bastian-bou/NixieNTPClock/README.md

# NixieNTPClock
Nixie clock around ESP32 connected to a NTP server

You can find the KiCad project and gerbers in **Hardware** folder and the PlatformIO project with arduino framwork in **Software** project

I am using ESP32 WROOM 32
