bastian-bou/NixieNTPClock/Hardware/NixieNTPClockFarnell.xlsx

Value | Footprint | Farnell | Quantité
100µF-16V | Capacitors_SMD:CP_Elec_6.3x7.7 | 1850114 | 1
100nF | Capacitors_SMD:C_0805_HandSoldering | 1740665 | 1
1nF | Capacitors_SMD:C_0603_HandSoldering | 1414605 (https://fr.farnell.com/kemet/c0603c102j5gactu/cond-1000pf-50v-5-c0g-np0-0603/dp/1414605) | 1
10K | Resistors_SMD:R_1206_HandSoldering | 2861595 (https://fr.farnell.com/te-connectivity/crgcq1206f10k/res-aec-q200-couche-epaisse-10k/dp/2861595) | 1
1K | Resistors_SMD:R_1206_HandSoldering | 1469965 (https://fr.farnell.com/vishay/crcw12061k00fkea/res-couche-epaisse-1k-1-0-25w/dp/1469965) | 1
33 | Resistors_SMD:R_1206_HandSoldering | 2447506 (https://fr.farnell.com/multicomp/mcwr12x33r0ftl/resistance-thick-film-33ohm-1/dp/2447506) | 1
TLC555 | Housings_DIP:DIP-8_W7.62mm_SMDSocket_SmallPads | 3121208 (https://fr.farnell.com/texas-instruments/tlc555cdr/ic-timer-smd-soic8-555/dp/3121208?st=TLC555) | 1
2200pF | Capacitors_SMD:C_0603_HandSoldering | 2470451 | 1
1mH 1A | Inductors:Inductor_Wurth_HCI-1335 | 2288316 | 1
Q_NMOS_GDS | TO_SOT_Packages_SMD:TO-252-2 | 2453852 | 1
4.7 | Resistors_SMD:R_1206_HandSoldering | 2447524 (https://fr.farnell.com/multicomp/mcwr12w4r70ftl/resistance-thick-film-4-7ohm-1/dp/2447524) | 1
MBRS3200T3G | Diodes_SMD:D_SMB_Handsoldering | 1838812 | 1
4.7µF-250V | Capacitors_SMD:CP_Elec_10x7.7 | 2326350 | 1
220K | Resistors_SMD:R_1206_HandSoldering | 2447485 (https://fr.farnell.com/multicomp/mcwr12x2203ftl/resistance-thick-film-220kohm/dp/2447485) | 1
470 | Resistors_SMD:R_1206_HandSoldering | 2447520 (https://fr.farnell.com/multicomp/mcwr12x4700ftl/res-couche-epaisse-470r-1-0-25w/dp/2447520) | 1
1K | Potentiometers:Potentiometer_Trimmer_Vishay_TS53YJ | 1141482 | 1
5K6 | Resistors_SMD:R_1206_HandSoldering | 2447530 (https://fr.farnell.com/multicomp/mcwr12x5601ftl/resistance-thick-film-5-6kohm/dp/2447530) | 1
BC850 | TO_SOT_Packages_SMD:SOT-23W_Handsoldering | 1081241 | 1
TLP627-4 | Housings_DIP:DIP-16_W7.62mm_Socket_LongPads | 1225840 | 1
220 | Resistors_SMD:R_1206_HandSoldering | 2447486 (https://fr.farnell.com/multicomp/mcwr12x2200ftl/res-couche-epaisse-220r-1-0-25w/dp/2447486) | 1
74HC7014 | Housings_SOIC:SOIC-14_3.9x8.7mm_Pitch1.27mm | 2777749 | 1
DS18B20 | TO_SOT_Packages_THT:TO-92_Inline_Wide | 2515553 (https://fr.farnell.com/maxim-integrated-products/ds18b20/temperature-sensor/dp/2515553?st=DS18B20) | 1
4.7K | Resistors_SMD:R_1206_HandSoldering | 2447523 (https://fr.farnell.com/multicomp/mcwr12x4701ftl/res-couche-epaisse-4-7k-1-0-25w/dp/2447523) | 1
FQT4N25TF | TO_SOT_Packages_SMD:SOT-223-3_TabPin2 | 2453914 | 4
100K | Resistors_SMD:R_1206_HandSoldering | 2447453 (https://fr.farnell.com/multicomp/mcwr12x1003ftl/res-couche-epaisse-100k-1-0-25w/dp/2447453) | 1
TPS562200 | TO_SOT_Packages_SMD:SOT-23-6 | 2781737 | 1
22µF | Capacitors_SMD:CP_Elec_5x5.8 | 9695737 | 5
4.7µH | Inductors:SELF-WE-TPC_M | 2066938 | 1
54K9 | Resistors_SMD:R_1206_HandSoldering | 2307762 (https://fr.farnell.com/panasonic/erj8enf5492v/res-couche-epaisse-54-9k-1-0-25w/dp/2307762) | 1
D_Zener | Diodes_SMD:D_SMB_Handsoldering | 2844801 | 1
7150 | Resistors_SMD:R_1206_HandSoldering | 2307836 | 1
LED | Diodes_SMD:D_0603 | 8529833 | 1
 | Support tulipe DIP 16 |  | 2
 | Barette tulipe 2,54mm
Embase LEMO 2p | Commande RS | 173-2253 | 1
