bastian-bou/NixieNTPClock/Hardware/Schema.pdf

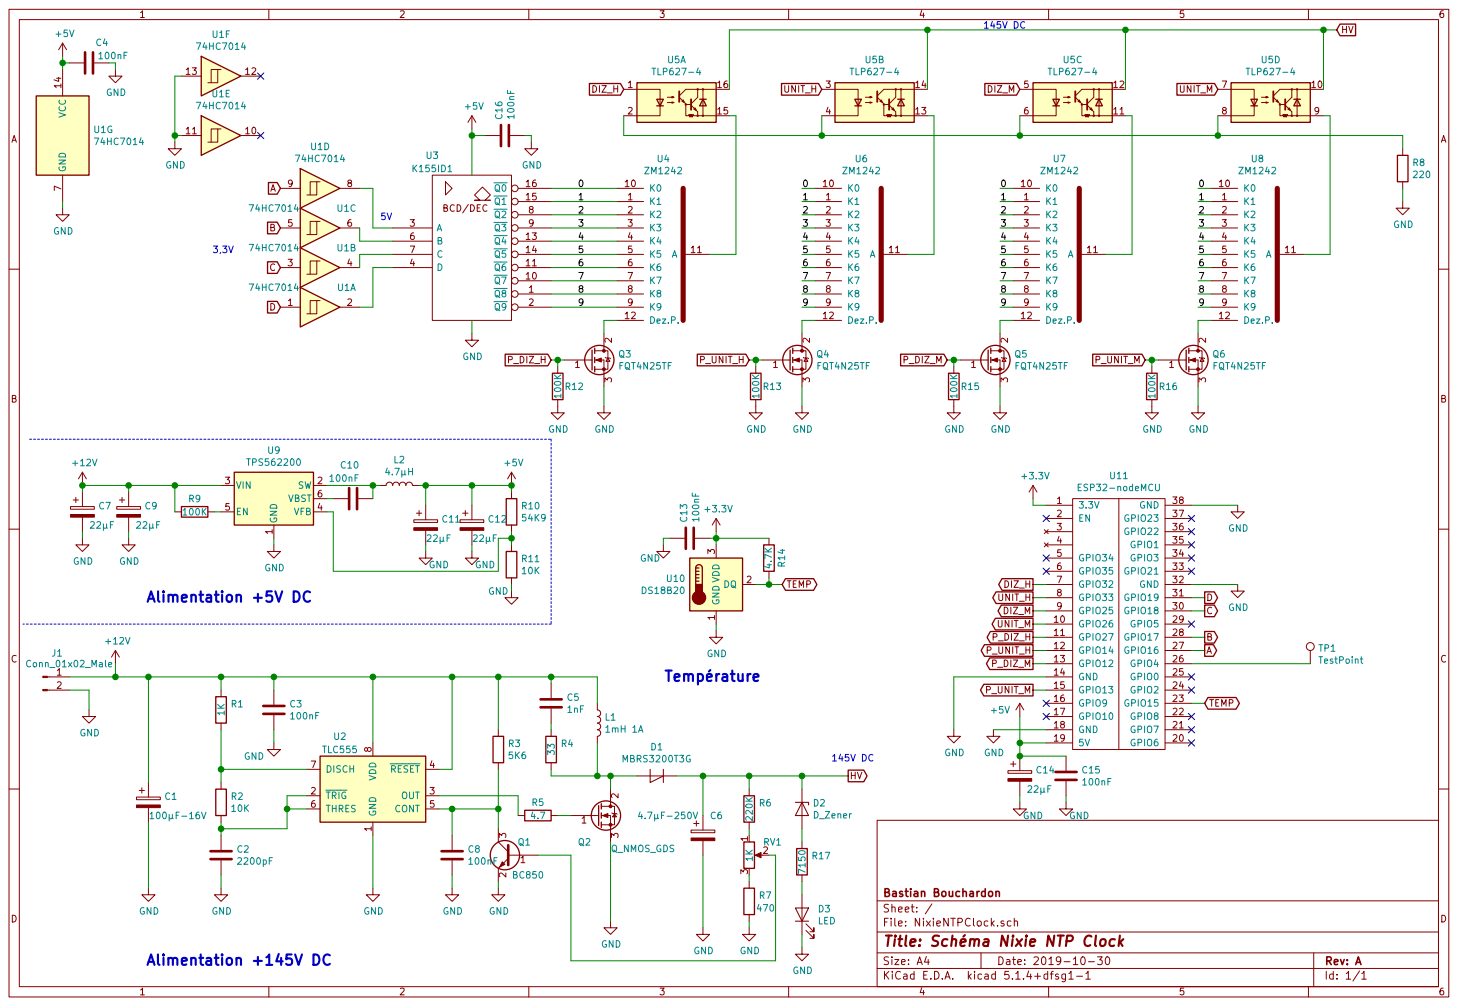
[picture p1: page 1]

1 SW 2 VIN 3 VFB 4 EN 5 VBST 6 U9 TPS562200 C7

8 U2 TLC555 R4 33 GND GND GND GND GND

1 TRIG 2 OUT 3 RESET 4 CONT 5 THRES 6 DISCH 7 VDD

Id: 1/1 Title: Schéma Nixie NTP Clock
