bastian-bou/NixieNTPClock/Hardware/NixieNTPClock/NixieNTPClock.kicad_pcb

## KiCad design Hardware/NixieNTPClock/NixieNTPClock.kicad_pcb (2019-11-25)

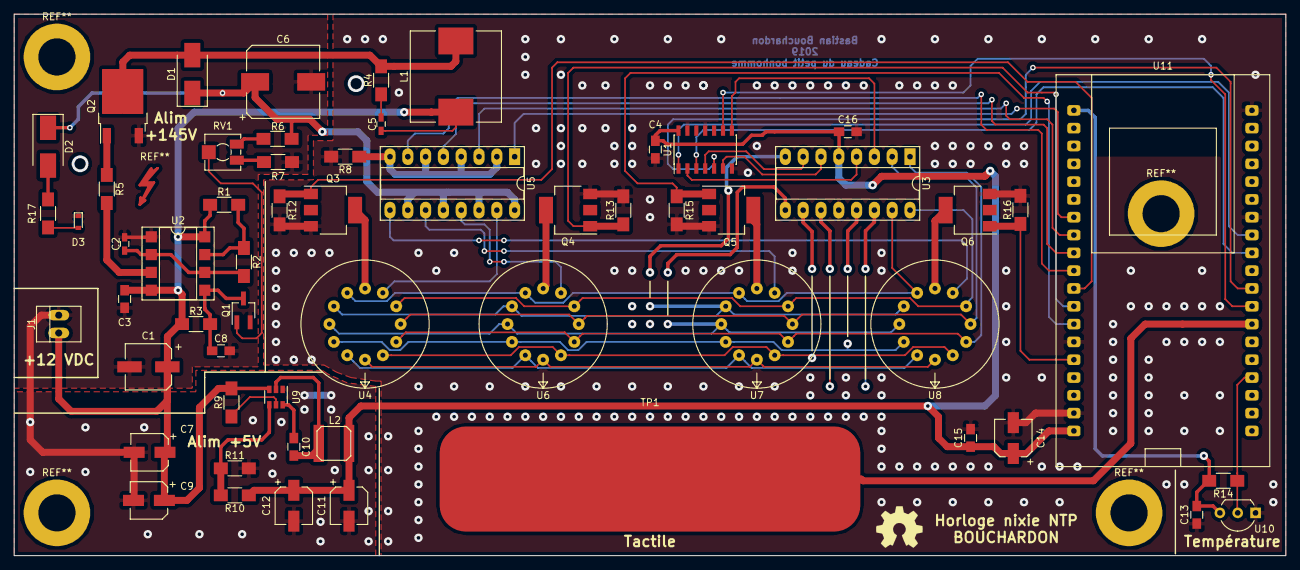
[picture p7: board NixieNTPClock.kicad_pcb from above]

Board: 4 copper layers, 181.4 x 77.2 mm, 58 parts (0 on the bottom side), 58 nets.

Parts:
C1: 100µF-16V; CP_Elec_6.3x7.7
C2: 2200pF; C_0603_HandSoldering
C3, C4, C8, C10, C13, C15, C16: 100nF; C_0805_HandSoldering
C5: 1nF; C_0603_HandSoldering
C6: 4.7µF-250V; CP_Elec_10x7.7
C7, C9, C11, C12, C14: 22µF; CP_Elec_5x5.8
D1: MBRS3200T3G; D_SMB_Handsoldering
D2: D_Zener; D_SMB_Handsoldering
D3: LED; D_0603
J1: Conn_01x02_Male; PINHEAD1-2
L1: 1mH 1A; Inductor_Wurth_HCI-1335
L2: 4.7µH; SELF-WE-TPC_M
Q1: BC850; SOT-23W_Handsoldering
Q2: Q_NMOS_GDS; TO-252-2
Q3, Q4, Q5, Q6: FQT4N25TF; SOT-223-3_TabPin2
R1: 1K; R_1206_HandSoldering
R2, R11: 10K; R_1206_HandSoldering
R3: 5K6; R_1206_HandSoldering
R4: 33; R_1206_HandSoldering
R5: 4.7; R_1206_HandSoldering
R6: 220K; R_1206_HandSoldering
R7: 470; R_1206_HandSoldering
R8: 220; R_1206_HandSoldering
R9, R12, R13, R15, R16: 100K; R_1206_HandSoldering
R10: 54K9; R_1206_HandSoldering
R14: 4.7K; R_1206_HandSoldering
R17: 7150; R_1206_HandSoldering
RV1: 1K; Potentiometer_Trimmer_Vishay_TS53YJ
TP1: TestPoint; touch
U1: 74HC7014; SOIC-14_3.9x8.7mm_Pitch1.27mm
U2: TLC555; DIP-8_W7.62mm_SMDSocket_SmallPads
U3: K155ID1; DIP-16_W7.62mm_Socket_LongPads
U4, U6, U7, U8: ZM1242
U5: TLP627-4; DIP-16_W7.62mm_Socket_LongPads
U9: TPS562200; SOT-23-6
U10: DS18B20; TO-92_Inline_Wide
U11: ESP32-nodeMCU; ESP32 NodeMCU AZ

Connections:
+3V3: C13.2, R14.2, U10.3, U11.1
+5V: C4.1, C11.1, C12.1, C14.1, C15.1, C16.1, L2.2, R10.1, U1.14, U3.5, U11.19
+12V: C1.1, C3.1, C5.1, C7.1, C9.1, J1.1, L1.1, R1.1, R3.1, R9.2, U2.4, U2.8, U9.3
/0: U3.16, U4.10, U6.10, U7.10, U8.10
/1: U3.15, U4.1, U6.1, U7.1, U8.1
/2: U3.8, U4.2, U6.2, U7.2, U8.2
/3: U3.9, U4.3, U6.3, U7.3, U8.3
/4: U3.13, U4.4, U6.4, U7.4, U8.4
/5: U3.14, U4.5, U6.5, U7.5, U8.5
/6: U3.11, U4.6, U6.6, U7.6, U8.6
/7: U3.10, U4.7, U6.7, U7.7, U8.7
/8: U3.1, U4.8, U6.8, U7.8, U8.8
/9: U3.2, U4.9, U6.9, U7.9, U8.9
A: U1.9, U11.27
B: U1.5, U11.28
C: U1.3, U11.30
D: U1.1, U11.31
DIZ_H: U5.1, U11.7
DIZ_M: U5.5, U11.9
GND: C1.2, C2.2, C3.2, C4.2, C6.2, C7.2, C8.2, C9.2, C11.2, C12.2, C13.1, C14.2, C15.2, C16.2, D3.1, J1.2, Q1.2, Q2.3, Q3.3, Q4.3, Q5.3, Q6.3, R7.2, R8.2, R11.2, R12.2, R13.2, R15.2, R16.2, U1.7, U1.11, U1.13, U2.1, U3.12, U9.1, U10.1, U11.14, U11.18, U11.32, U11.38
HV: C6.1, D1.1, D2.1, R6.1, U5.10, U5.12, U5.14, U5.16
unnamed: C2.1, R2.2, U2.2, U2.6
unnamed: C5.2, R4.1
unnamed: C8.1, Q1.3, R3.2, U2.5
unnamed: C10.1, U9.6
unnamed: C10.2, L2.1, U9.2
unnamed: D1.2, L1.2, Q2.2, R4.2
unnamed: D2.2, R17.1
unnamed: D3.2, R17.2
unnamed: Q1.1, RV1.2
unnamed: Q2.1, R5.1
unnamed: Q3.2, U4.12
unnamed: Q4.2, U6.12
unnamed: Q5.2, U7.12
unnamed: Q6.2, U8.12
unnamed: R1.2, R2.1, U2.7
unnamed: R5.2, U2.3
unnamed: R6.2, RV1.1
unnamed: R7.1, RV1.3
unnamed: R8.1, U5.2, U5.4, U5.6, U5.8
unnamed: R9.1, U9.5
unnamed: R10.2, R11.1, U9.4
unnamed: TP1.1, U11.26
unnamed: U1.2, U3.4
unnamed: U1.4, U3.7
unnamed: U1.6, U3.6
unnamed: U1.8, U3.3
unnamed: U4.11, U5.15
unnamed: U5.9, U8.11
unnamed: U5.11, U7.11
unnamed: U5.13, U6.11
P_DIZ_H: Q3.1, R12.1, U11.11
P_DIZ_M: Q5.1, R15.1, U11.13
P_UNIT_H: Q4.1, R13.1, U11.12
P_UNIT_M: Q6.1, R16.1, U11.15
TEMP: R14.1, U10.2, U11.23
UNIT_H: U5.3, U11.8
UNIT_M: U5.7, U11.10
