bastian-bou/NixieNTPClock/(commit log)

2019-10-27 Add kicad project files with a beginning of schematic (high voltage power supply unit)
    [NixieNTPClock.kicad_pcb, NixieNTPClock.sch]
2019-10-27 Add documentation with siemens datasheet Add farnel refs and component refs in schematic
    [NixieNTPClock.sch]
2019-10-27 Add nixie command in schema, nixie library in project and pdf in documentation
    [NixieNTPClock.sch]
2019-10-28 nixie command finished, add 5V DC power supply and temp sensor
    [NixieNTPClock.sch]
2019-10-28 Add command code for farnell in schematic
    [NixieNTPClock.sch]
2019-10-29 Add ESP32 NODE MCU library + labels for connection with ESP32
    [NixieNTPClock.sch]
2019-10-30 Add multiple references (not finished) Finish schematic
    [NixieNTPClock.sch]
2019-10-30 add no important things
    [NixieNTPClock.sch]
2019-11-02 Update Schema Add footprint library Finish netlist Started rooting
    [NixieNTPClock.kicad_pcb, NixieNTPClock.sch]
2019-11-08 Continu on PCB ...
    [NixieNTPClock.kicad_pcb]
2019-11-12 Hardware: power supply
    [NixieNTPClock.kicad_pcb]
2019-11-15 debug nixie lib + TODO: fix debug.print
    [debug.h]
2019-11-20 Continuous routing ...
    [NixieNTPClock.kicad_pcb]
2019-11-24 PCB almost finished
    [NixieNTPClock.kicad_pcb]
2019-11-25 Finished PCB and added pdf and gerber files
    [NixieNTPClock.kicad_pcb]
2019-11-25 Add gerber files, zip and PDF
    [NixieNTPClock-B.Cu.gbr, NixieNTPClock-B.Mask.gbr, NixieNTPClock-B.Paste.gbr, NixieNTPClock-B.SilkS.gbr, NixieNTPClock-Edge.Cuts.gbr, NixieNTPClock-F.Cu.gbr, NixieNTPClock-F.Mask.gbr, NixieNTPClock-F.Paste.gbr]
2019-11-27 Add BOM list
    [NixieNTPClockFarnell.xlsx]
2019-11-28 Add simple wifi connexion, add new methods in Nixie lib with animation, temperature, clear ...
2019-12-09 Wifi is working, all the features are working except Temp because I don't have the sensor yet
2019-12-17 Improve the method to display temp ant time Add parameter to set tubes with specific values in refresh Imporve NTP get time after temperature
2019-12-23 Add test loop if you touch capacitive button at start Add testNixie method in Nixie library Add datasheet of TLP627 opto-darlington
2019-12-24 fix decimal temperature and add NOP() in refresh nixie tubes
    [main.cpp]
2020-01-11 Update every hour with NTP server Fix Time shifting
    [main.cpp]
2020-03-11 Resolve rollover on µs timeout Add macro to cast esp_timer_get_time() into unsigned 64 bits
    [main.cpp]
2023-12-24 Add comments, improve code, add preprocessor error with info about params.h
    [main.cpp]
